monishkumaravelan01/Motion-node/Altium Schematics/Motion Node IMU1.png

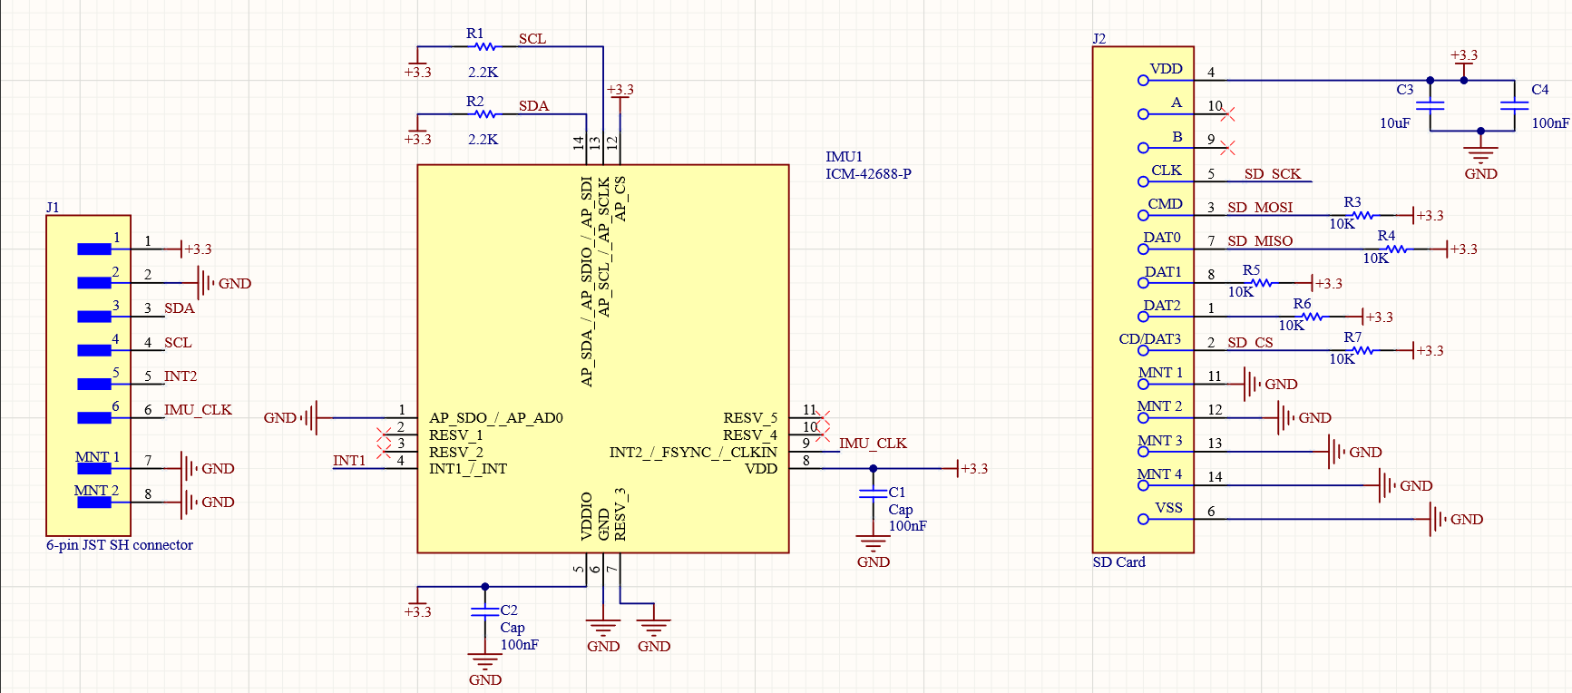
Altium Schematics/Motion Node IMU1.png
