monishkumaravelan01/Motion-node/Altium Schematics/Motion Node IMU 2.png

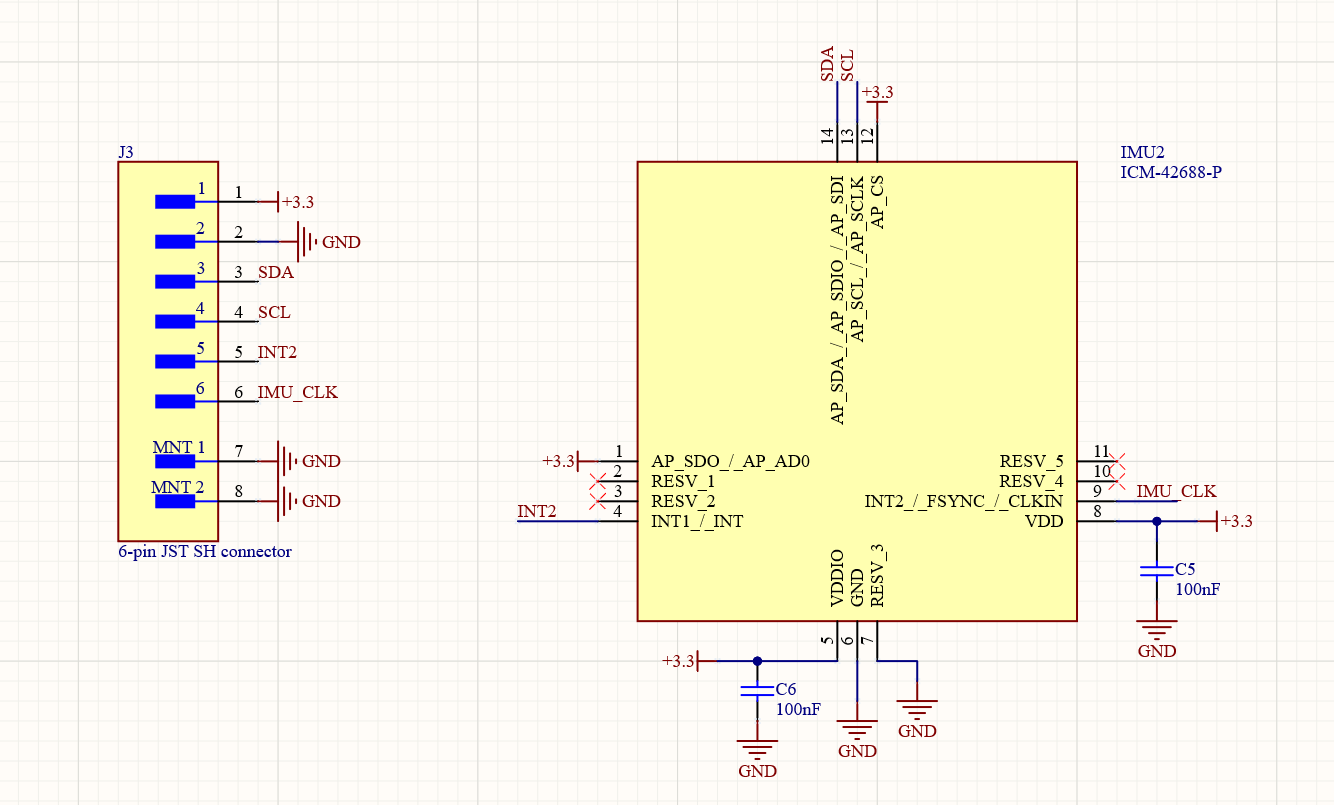
Altium Schematics/Motion Node IMU 2.png
