monishkumaravelan01/Motion-node/Altium Schematics/Motion Node Main board.png

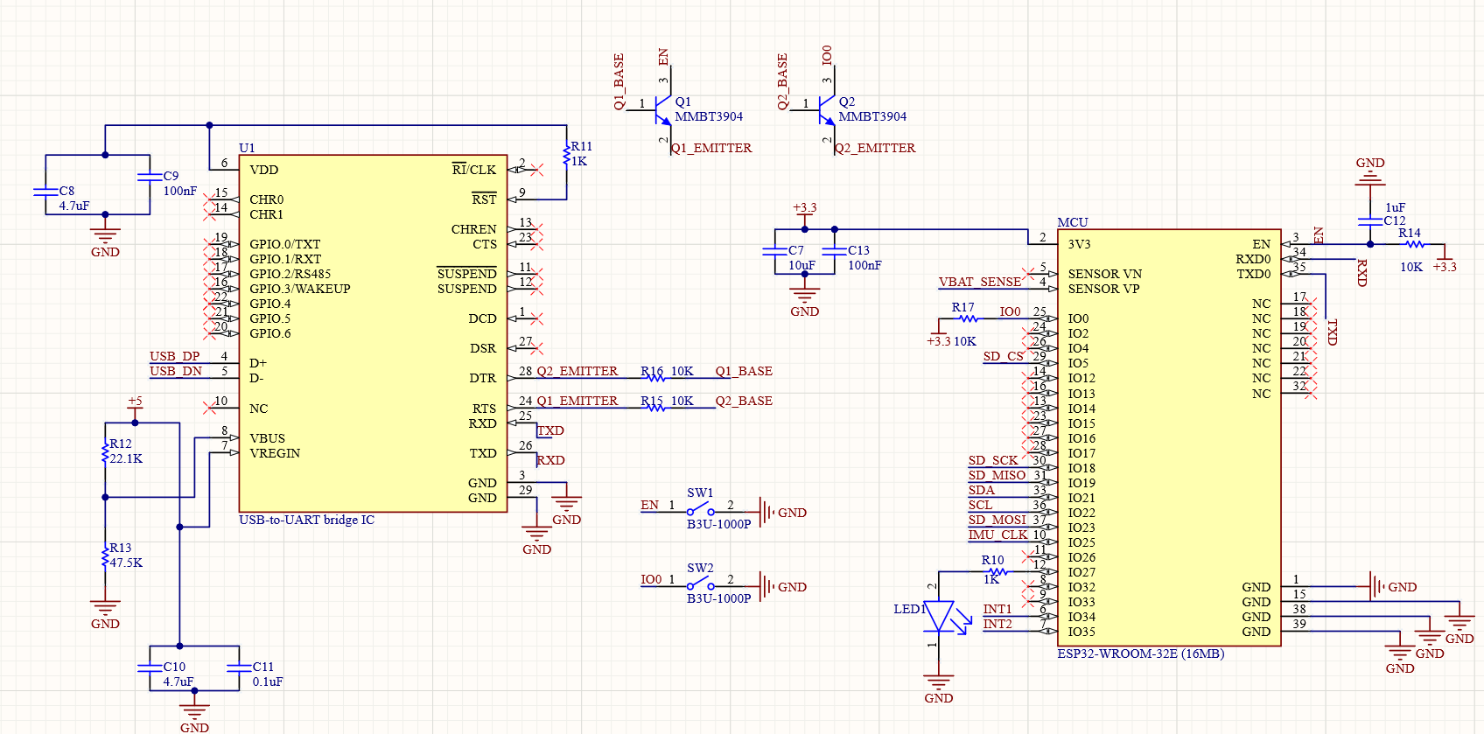
Altium Schematics/Motion Node Main board.png
