monishkumaravelan01/Motion-node/Altium Schematics/Motion node power circuit board.png

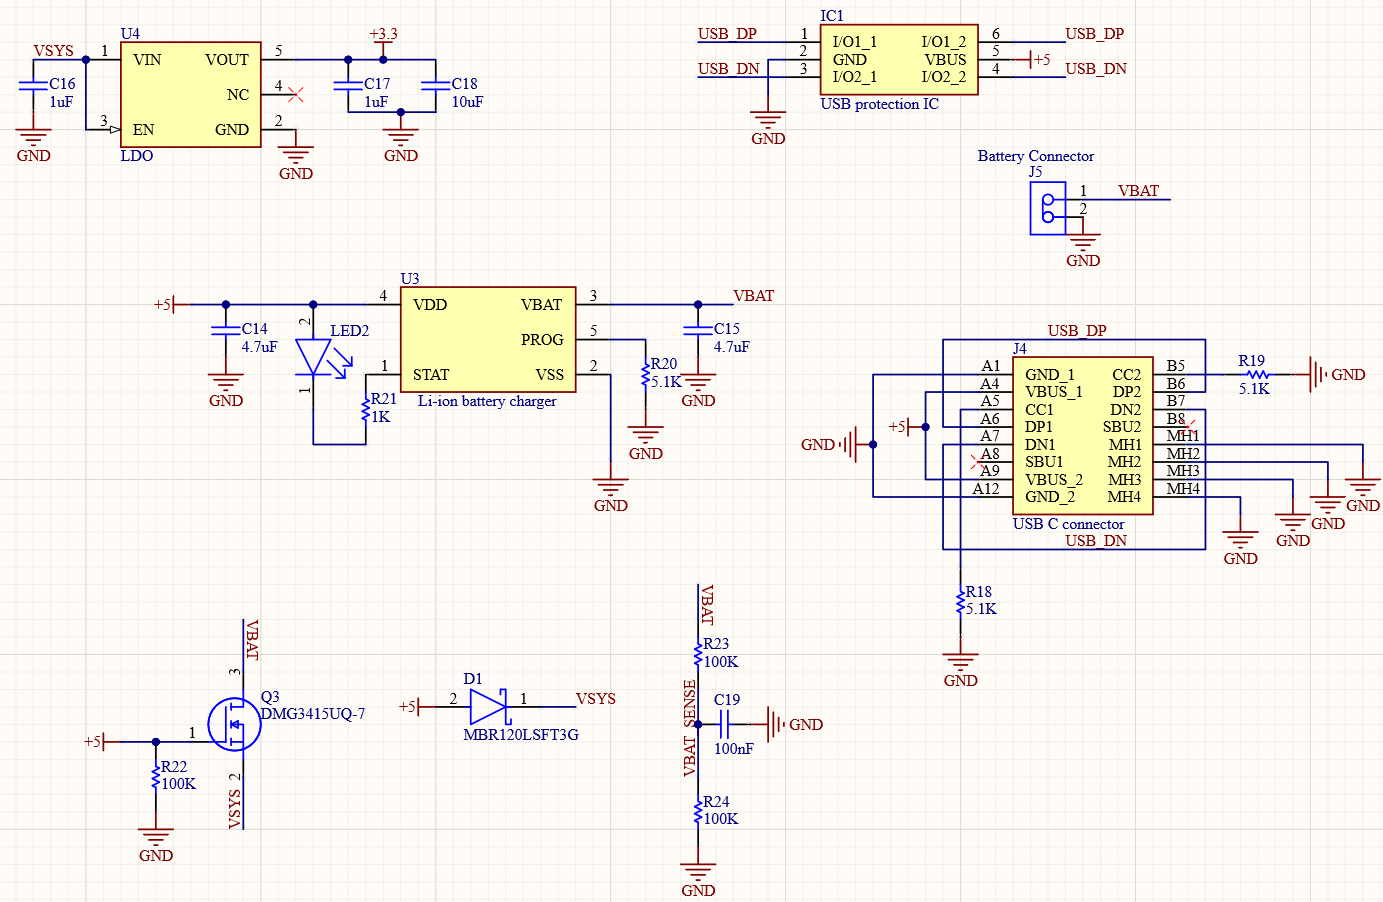
Altium Schematics/Motion node power circuit board.png
