monishkumaravelan01/Motion-node/Wokwi Files/Wokwi sim.png

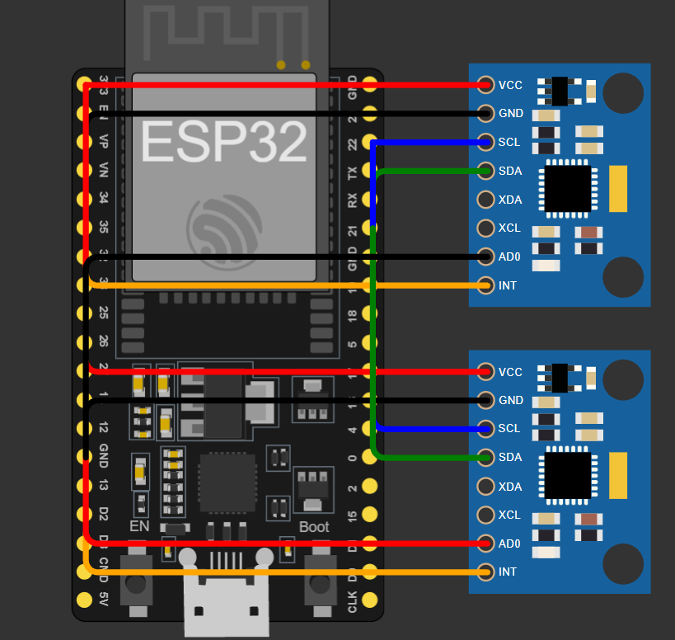
Wokwi Files/Wokwi sim.png
