monishkumaravelan01/Motion-node/(commit log)

2026-11-11 Added Imuconfig and improved files organisation
2026-11-13 Added PCB schematics and Wokwi sim image
2026-11-13 Rename ImuConfig.h to Wokwi Files/ImuConfig.h
2026-11-13 Rename Motion Node IMU 2.png to Altium Schematics/Motion Node IMU 2.png
2026-11-13 Rename Motion Node IMU1.png to Altium Schematics/Motion Node IMU1.png
2026-11-13 Rename Motion Node Main board.png to Altium Schematics/Motion Node Main board.png
2026-11-13 Rename Motion node power circuit board.png to Altium Schematics/Motion node power circuit board.png
2026-11-13 Rename logs.csv to python analysis/logs.csv
    [logs.csv]
